damienmaguire/Ampera-Volt-Inverter/README.md

# Ampera-Volt-Inverter
Open Source Logic board for the Opel Ampera and Chevy Volt Inverter

Based on the work of A.Kramer.

Designfiles in DesignSpark PCB 9.0 format.

Incorporates the option to parallel the two main powerstages.

Includes Lebowski system to run the aux inverter. e.g. aircon pump.
