damienmaguire/Ampera-Volt-Inverter/Hardware/Ampera_V1_BOM_JLC.xls

Comment | Designator | Package | LCSC Part #
1N4148WS | D3 | SOD-323F | C2128
470UF 6.3V | C50 | CASE-E_7343 | C76438
ACPL-C790-500E | IC1 | SO-8_5.9x6.8x1.27P | C81946
0.1uF | C36,C63,C9,C68,C6,C64,C65,C49,C21,C17,C16,C14 | 0805_C | C49678
1nF | C57,C59,C28,C27,C60,C47,C46 | 0805_C | C46653
1UF | C24,C12,C13,C3,C5,C10,C2,C8,C11,C1,C4,C54,C55,C56,C66,C67,C51,C45,C23,C33,C22,C40,C25 | 0805_C | C28323
10nF | C39,C58,C61,C62 | 0805_C | C1710
22n | C38,C37,C35,C34,C7,C31 | 0805_C | C1729
22pF | C19,C20 | 0805_C | C1804
10uF | C29,C30,C26,C52 | 0805_C | C15850
DSPIC30F4011-30I/PT | IC2 | TQFP-44_10.0x10.0x0.8P | C27955
LED GREEN | LED1,LED2,LED6 | LED_0805 | C2297
LED RED | LED3 | LED_0805 | C84256
LED ORANGE | LED4 | LED_0805 | C205444
LED YELLOW | LED5 | LED_0805 | C2296
10uH | L1,L2 | 0603 | C1035
MMBT3904 | TR1,TR2,TR3,TR4,TR5,TR6,TR7 | SOT-23-3 | C20526
MP2359 | IC8 | TSOT-23-6 | C14259
MWSA0503-100MT | L3 | SMD-PIND-5.2x5.4x2.8_1.2x2.2 | C139506
NCV8402ASTT1G | IC6,IC7 | SOT-223 | C77755
OPA344NA/250 | IC9 | SOT-23-5 | C131974
0Ω | R59 | 0805_R | C17477
1KΩ | R38,R48,R61,R79,R69,R80,R30,R29,R14,R20,R1,R78,R66,R65,R60,R57,R56,R44,R70,R73,R74,R75,R114 | 0805_R | C17513
1.2KΩ | R93 | 0805_R | C17379
1.5KΩ | R5,R7,R11,R3,R9 | 0805_R | C4310
2.2KΩ | R94 | 0805_R | C17520
3.3KΩ | R62,R71,R84,R83,R82,R76,R42,R41,R113 | 0805_R | C26010
4.7KΩ | R8,R4,R10,R6,R12,R87,R88,R89,R90,R91,R92,R95,R96,R64 | 0805_R | C17673
4.7Ω | R19,R112 | 0805_R | C17675
6.8KΩ | R72,R63,R45,R46 | 0805_R | C17772
8.2KΩ | R109 | 0805_R | C17828
10KΩ | R58,R54,R53,R52,R50,R32,R31,R16,R18,R15,R17,R77,R2,R81,R86,R28,R47,R51,R97 | 0805_R | C17414
43KΩ | R110 | 0805_R | C17695
100KΩ | R111 | 0805_R | C17407
100Ω | R43,R36,R39,R35,R37,R34,R100,R85,R101,R98,R102,R99,R103,R104,R105,R106,R107,R108 | 0805_R | C17408
120Ω | R40,R49 | 0805_R | C17437
220Ω | R21,R22,R23,R24 | 0805_R | C17557
330Ω | R67,R68,R33 | 0805_R | C17630
680Ω | R115,R116,R117,R118 | 0805_R | C17798
470K | R13,R25,R26 | 2512_R | C55559
SN65HVD230DR | IC5 | SOIC-8_3.9x4.9x1.27P | C12084
SS54 | D1,D2 | SMA,DO-214AC | C22452
STM32F103RBT6 | IC4 | LQFP-64_10.0x10.0x0.5P | C8735
100UF 6.3V | C44,C43,C42,C41,C32,C53,C15,C18 | CASE-B_3528 | C16133
TDA2822 | IC3 | SOP-8_3.9x4.9x1.27P | C73296
TJA1050T | IC13 | SOIC-8_3.9x4.9x1.27P | C6952
470uF 25V | C48 | SMD-ECAP-10x10 | C249931
8MHz | X1 | SMD-5032_2P | C115962
3V3 REG | LD1,LD2 | SOT-23-3L | C5446
