damienmaguire/Ampera-Volt-Inverter/Hardware/Ampera_V1 - PCB.pdf

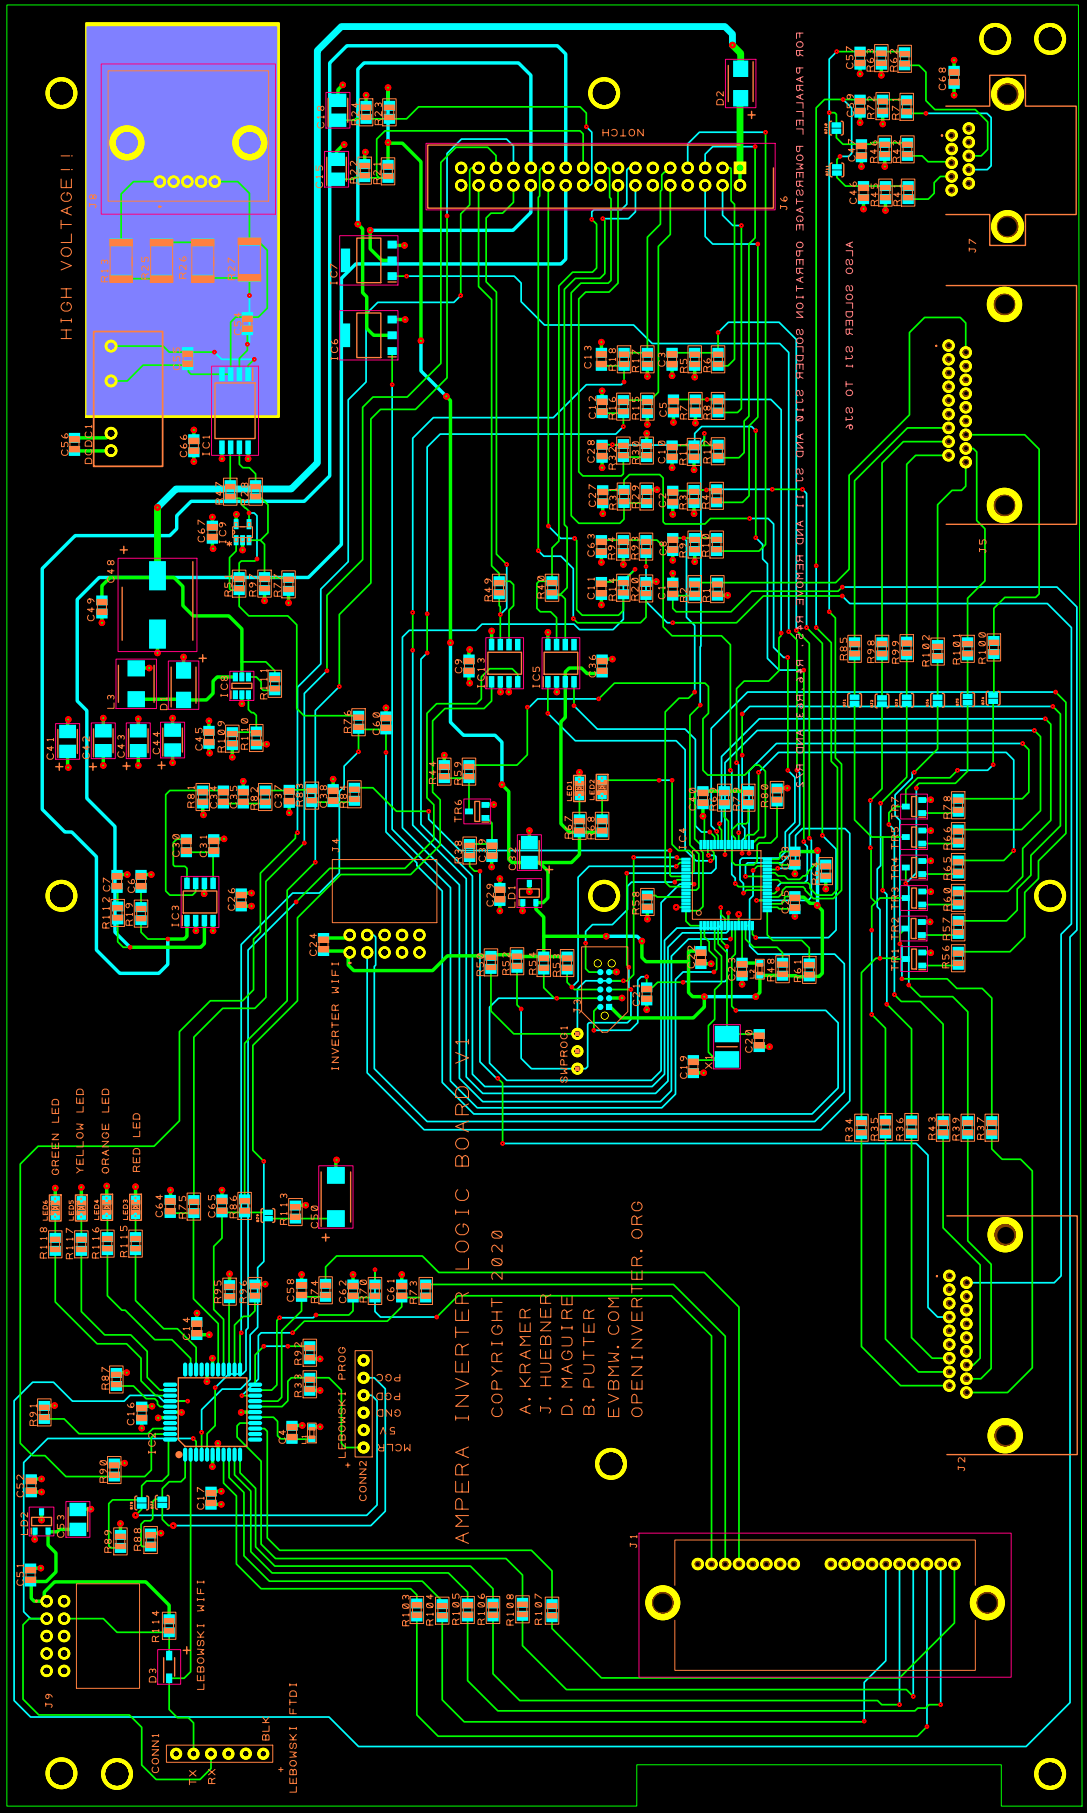
[picture p4: page 1]
