damienmaguire/Ampera-Volt-Inverter/Hardware/Ampera_V1 - Schematic.pdf

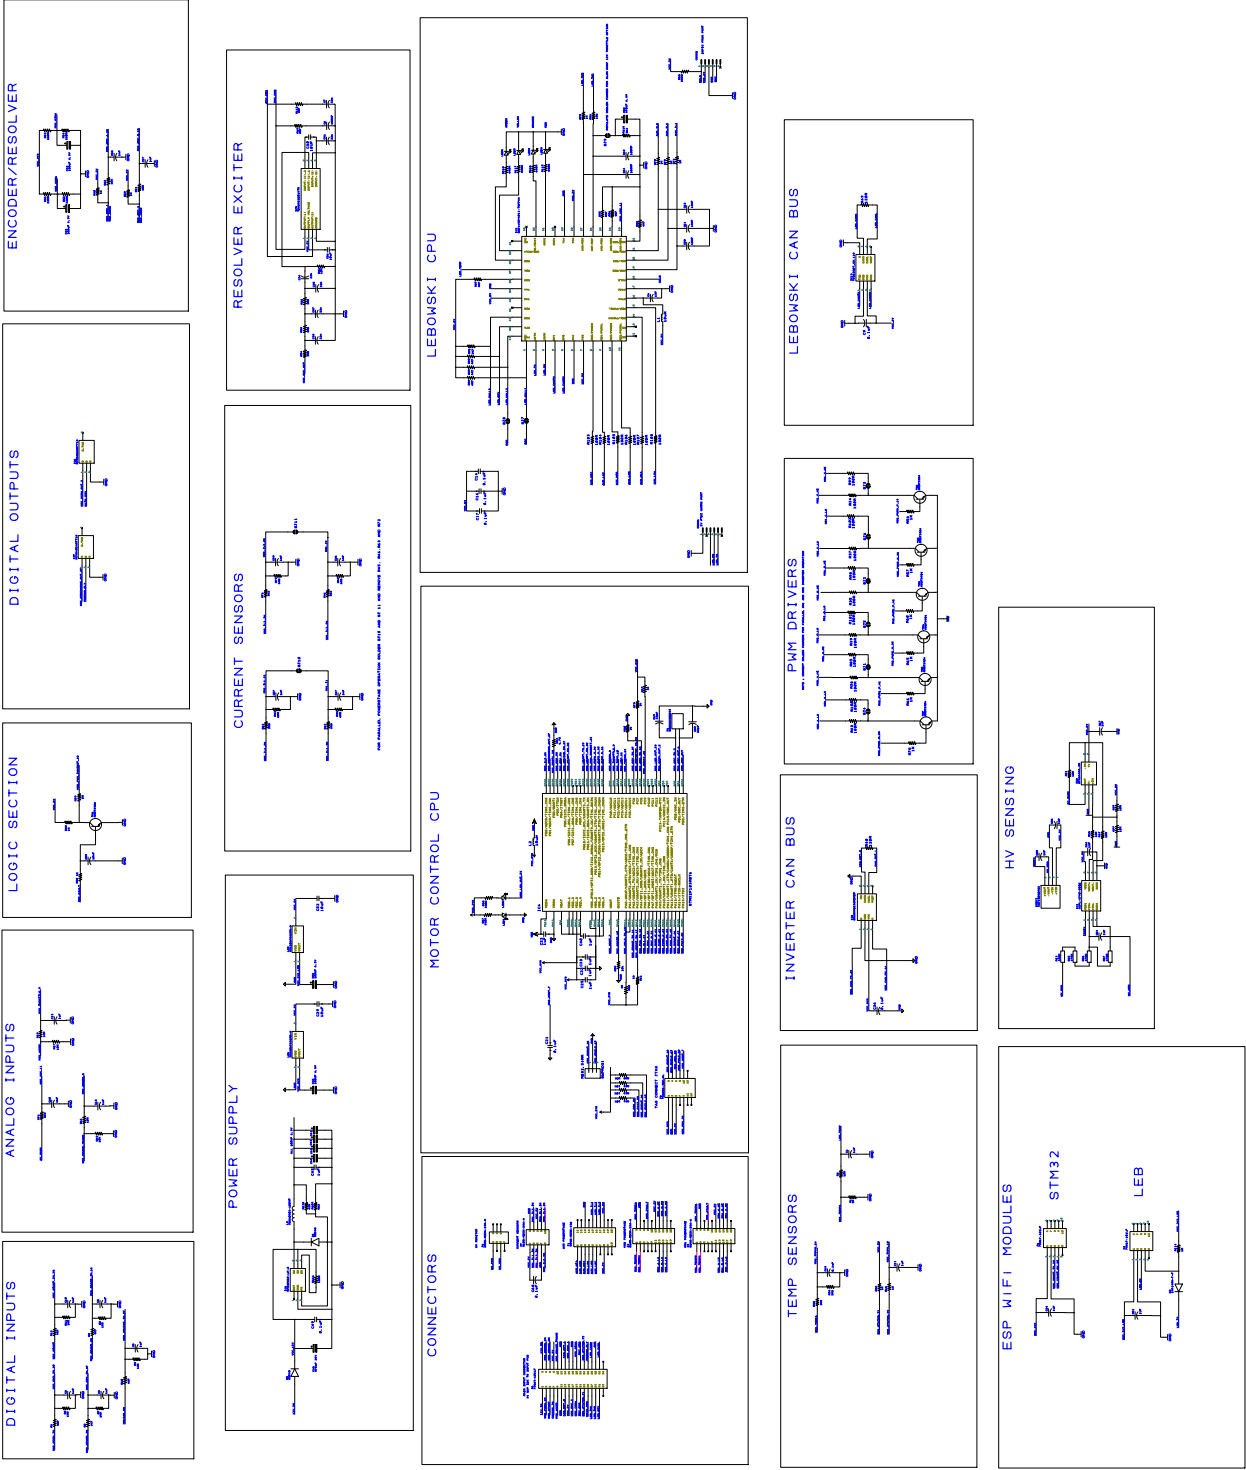
[picture p5: page 1]
