damienmaguire/Ampera-Volt-Inverter/Hardware/smdlebowski.pdf

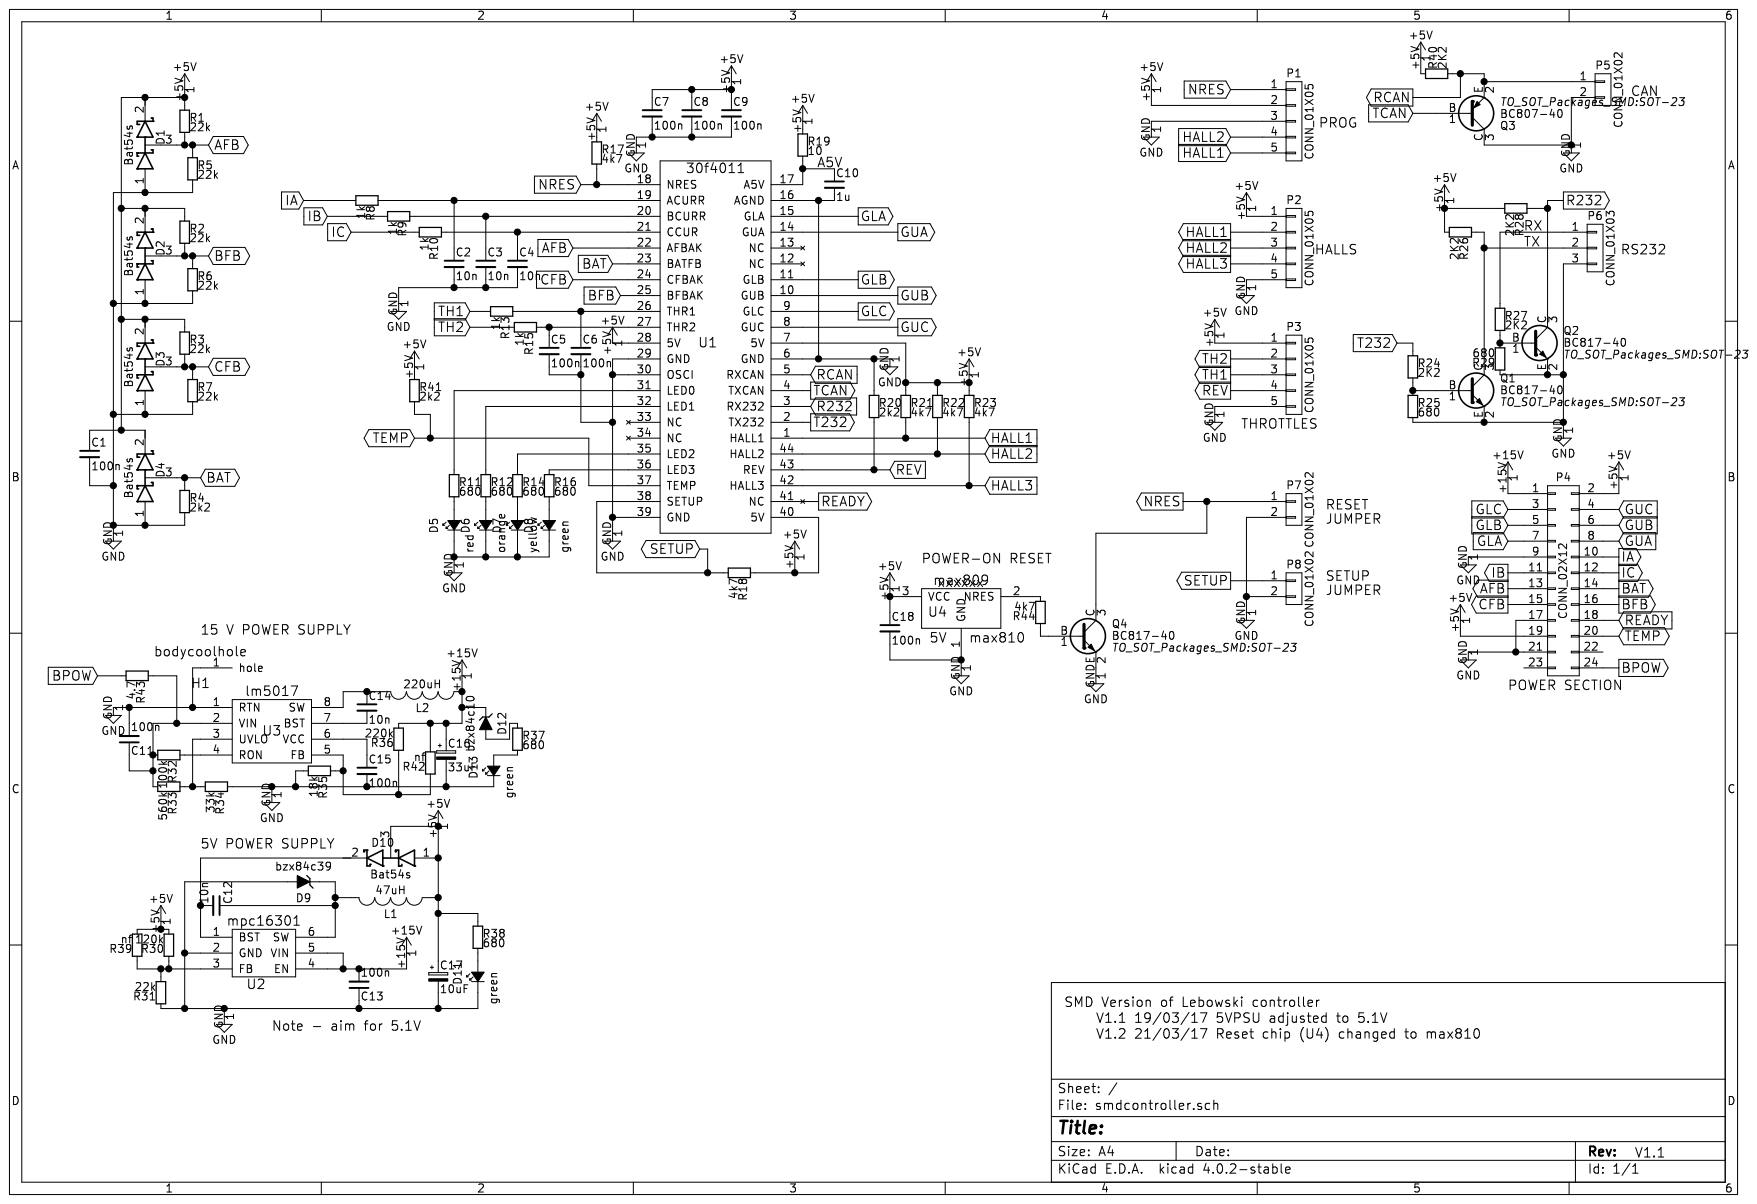
[picture p6: page 1]
