damienmaguire/Ampera-Volt-Inverter/(list of files, drawings)

Other design files:
Hardware/Ampera_V1.pcb
